enkhbold470/iron-node/media/bottom.png

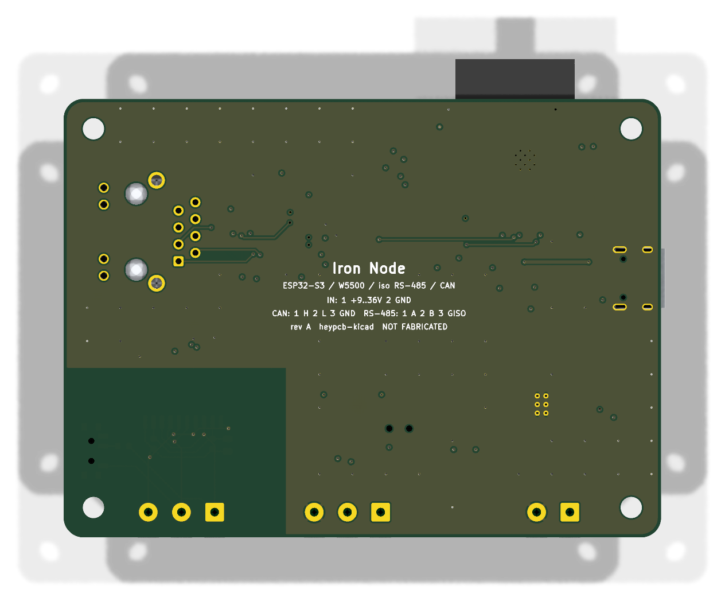
media/bottom.png
