enkhbold470/iron-node/media/top.png

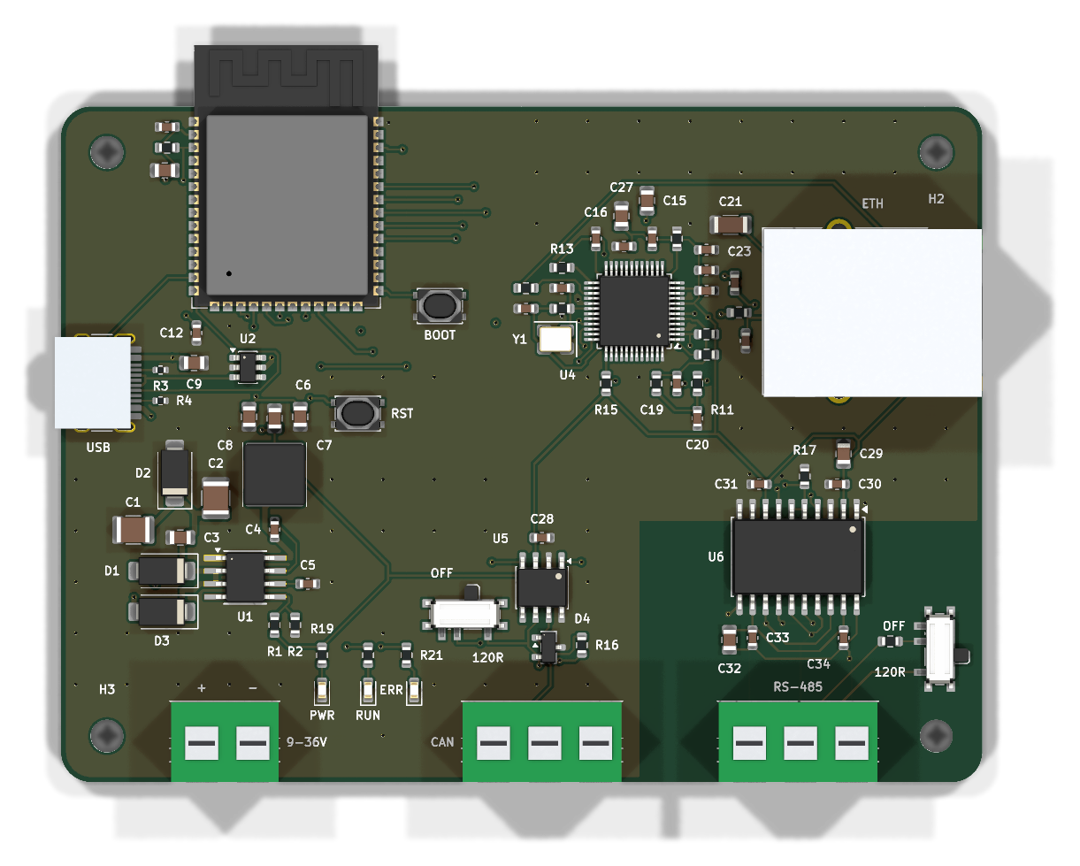
media/top.png
