enkhbold470/iron-node/fab/iron_node_bom.csv

Reference | Value | Footprint | MPN | LCSC | Qty
C1,C2 | 2.2uF | Capacitor_SMD:C_1210_3225Metric | FS32X225K101EGG | C153036 | 2
C3 | 100nF | Capacitor_SMD:C_0805_2012Metric | CL21B104KCFNNNE | C28233 | 1
C4,C10,C22,C23,C24,C25,C26,C28,C30,C31,C33,C34 | 100nF | Capacitor_SMD:C_0603_1608Metric | CC0603KRX7R9BB104 | C14663 | 12
C5,C12 | 1uF | Capacitor_SMD:C_0603_1608Metric | CL10A105KB8NNNC | C15849 | 2
C6,C7,C8,C11 | 22uF | Capacitor_SMD:C_0805_2012Metric | CL21A226MAQNNNE | C45783 | 4
C9,C27,C29,C32 | 10uF | Capacitor_SMD:C_0805_2012Metric | CL21A106KAYNNNE | C15850 | 4
C13,C14 | 18pF | Capacitor_SMD:C_0603_1608Metric | CL10C180JB8NNNC | C1647 | 2
C15 | 4.7uF | Capacitor_SMD:C_0805_2012Metric | CL21A475KAQNNNE | C1779 | 1
C16,C20 | 10nF | Capacitor_SMD:C_0603_1608Metric | 0603B103K500NT | C57112 | 2
C17 | 22nF | Capacitor_SMD:C_0603_1608Metric | CL10B223KB8NNNC | C21122 | 1
C18,C19 | 6.8nF | Capacitor_SMD:C_0603_1608Metric | 0603B682K500NT | C1631 | 2
C21 | 1nF | Capacitor_SMD:C_1206_3216Metric | 1206B102K202NT | C9196 | 1
D1,D3 | SS36 | Diode_SMD:D_SMA | SS36 | C16015 | 2
D2 | SMAJ36A | Diode_SMD:D_SMA | SMAJ36A | C113967 | 1
D4 | NUP2105L | Package_TO_SOT_SMD:SOT-23 | NUP2105LT1G | C14486 | 1
D5 | Red (PWR) | LED_SMD:LED_0603_1608Metric | KT-0603R | C2286 | 1
D6 | Orange (RUN) | LED_SMD:LED_0603_1608Metric | XL-1608UOC-06 | C965800 | 1
D7 | Red (ERR) | LED_SMD:LED_0603_1608Metric | KT-0603R | C2286 | 1
J1 | 9-36V IN | TerminalBlock:TerminalBlock_MaiXu_MX126-5.0-02P_1x02_P5.00mm | MX126-5.0-02P-GN01-Cu-S-A | C5188434 | 1
J2 | USB-C | Connector_USB:USB_C_Receptacle_HRO_TYPE-C-31-M-12 | TYPE-C-31-M-12 | C165948 | 1
J3 | HR911105A | Connector_RJ:RJ45_Hanrun_HR911105A_Horizontal | HR911105A | C12074 | 1
J4 | CAN | TerminalBlock:TerminalBlock_MaiXu_MX126-5.0-03P_1x03_P5.00mm | MX126-5.0-03P-GN01-Cu-S-A | C5188435 | 1
J5 | RS-485 | TerminalBlock:TerminalBlock_MaiXu_MX126-5.0-03P_1x03_P5.00mm | MX126-5.0-03P-GN01-Cu-S-A | C5188435 | 1
L1 | 22uH | Inductor_SMD:L_Sunlord_SWPA6045S | SWPA6045S220MT | C83454 | 1
R1 | 47k | Resistor_SMD:R_0603_1608Metric | 0603WAF4702T5E | C25819 | 1
R2 | 20k | Resistor_SMD:R_0603_1608Metric | 0603WAF2002T5E | C4184 | 1
R3,R4 | 5.1k | Resistor_SMD:R_0402_1005Metric | 0402WGF5101TCE | C25905 | 2
R5,R15,R17 | 10k | Resistor_SMD:R_0603_1608Metric | 0603WAF1002T5E | C25804 | 3
R6 | 1M | Resistor_SMD:R_0603_1608Metric | 0603WAF1004T5E | C22935 | 1
R7 | 12.4k | Resistor_SMD:R_0603_1608Metric | FRC0603F1242TS | C2930060 | 1
R8,R9,R11,R12 | 49.9 | Resistor_SMD:R_0603_1608Metric | 0603WAF499JT5E | C23185 | 4
R10 | 10 | Resistor_SMD:R_0603_1608Metric | 0603WAF100JT5E | C22859 | 1
R13,R14 | 330 | Resistor_SMD:R_0603_1608Metric | 0603WAF3300T5E | C23138 | 2
R16,R18 | 120 | Resistor_SMD:R_0603_1608Metric | 0603WAF1200T5E | C22787 | 2
R19,R20,R21 | 1k | Resistor_SMD:R_0603_1608Metric | 0603WAF1001T5E | C21190 | 3
SW1,SW2 | PCM12 | Button_Switch_SMD:SW_SPDT_PCM12 | PCM12SMTR | C221841 | 2
SW3 | BOOT | Button_Switch_SMD:SW_SPST_PTS810 | PTS810SJM250SMTRLFS | C116501 | 1
SW4 | RESET | Button_Switch_SMD:SW_SPST_PTS810 | PTS810SJM250SMTRLFS | C116501 | 1
U1 | LMR36510ADDAR | Package_SO:Texas_HTSOP-8-1EP_3.9x4.9mm_P1.27mm_EP2.95x4.9mm_Mask2.4x3.1mm_ThermalVias | LMR36510ADDAR | C1858393 | 1
U2 | USBLC6-2SC6 | Package_TO_SOT_SMD:SOT-23-6 | USBLC6-2SC6 | C7519 | 1
U3 | ESP32-S3-WROOM-1-N8R8 | RF_Module:ESP32-S3-WROOM-1 | ESP32-S3-WROOM-1-N8R8 | C2913201 | 1
U4 | W5500 | Package_QFP:LQFP-48_7x7mm_P0.5mm | W5500 | C32843 | 1
U5 | SN65HVD230DR | Package_SO:SOIC-8_3.9x4.9mm_P1.27mm | SN65HVD230DR | C12084 | 1
U6 | ADM2587EBRWZ | Package_SO:SOIC-20W_7.5x12.8mm_P1.27mm | ADM2587EBRWZ-REEL7 | C12081 | 1
Y1 | 25MHz | Crystal:Crystal_SMD_3225-4Pin_3.2x2.5mm | X322525MOB4SI | C9006 | 1
