enkhbold470/iron-node/fab/iron_node.step

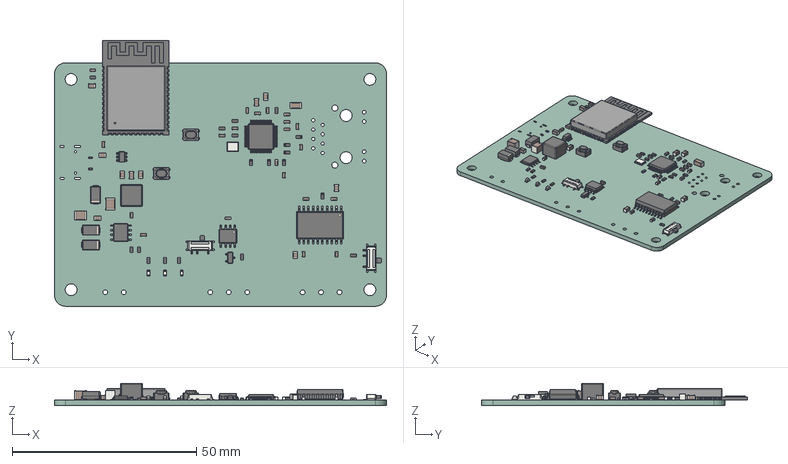
[picture p5: CAD file, 2026-10-02]
fab/iron_node.step
90.0 x 72.0 x 6.09 mm
R_0603_1608Metric x 19
C_0805_2012Metric x 10
C_0603_1608Metric x 21
R_0402_1005Metric x 2
SOIC-8_3.9x4.9mm_P1.27mm
D_SMA x 3
LED_0603_1608Metric x 3
C_1210_3225Metric x 2
a6c163e6-8551-11ed-a139-00155d22e2d7_part
a6c16512-8551-11ed-a139-00155d22e2d7_part
a6c16594-8551-11ed-a139-00155d22e2d7_part
SOIC-20W_7.5x12.8mm_P1.27mm
SW_SPST_PTS810 x 2
Texas_HTSOP_8_1EP_39x49mm_P127mm_EP285x49mm_Mask24x31mm_ThermalVias
SOT-23
Fusion_sp x 2
C_1206_3216Metric
ESP32-S3-WROOM-1
Crystal_SMD_3225-4Pin_3.2x2.5mm
LQFP-48_7x7mm_P0.5mm
SOT-23-6
iron_node_PCB
