enkhbold470/iron-node/fab/iron_node_schematic.pdf

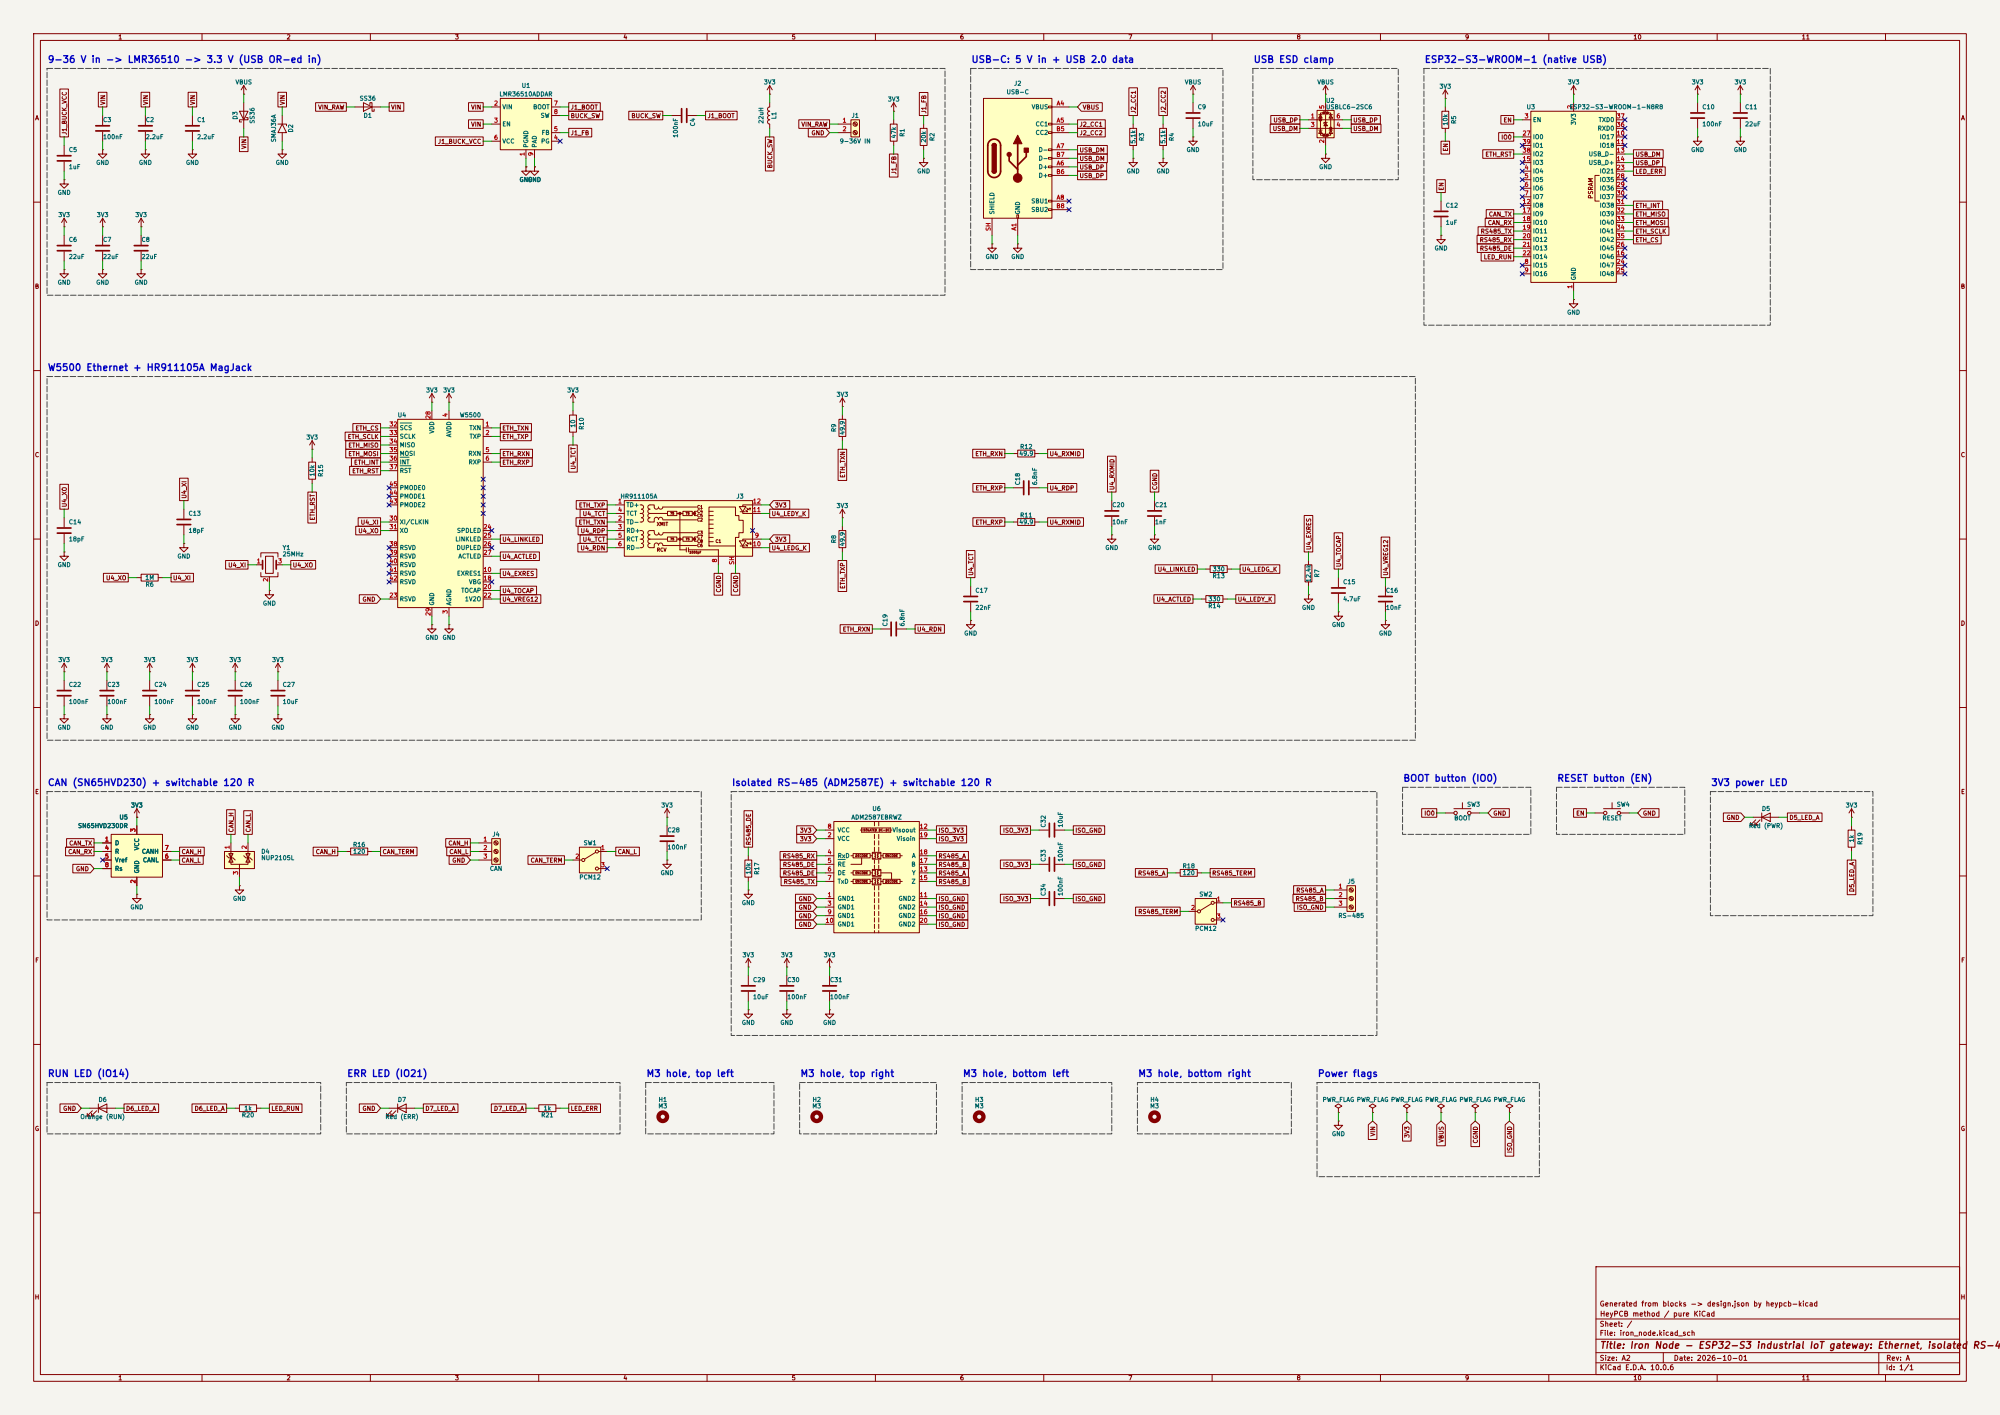
[picture p6: page 1]

HeyPCB method / pure KiCad
Sheet: /
File: iron_node.kicad_sch
Title: Iron Node - ESP32-S3 industrial IoT gateway: Ethernet, isolated RS-485, CAN, 9-36 V in

Size: A2 | Rev: A
KiCad E.D.A. 10.0.6 | Id: 1/1
