enkhbold470/iron-node/kicad/iron_node.kicad_pcb

## KiCad design kicad/iron_node.kicad_pcb (2026-10-02)

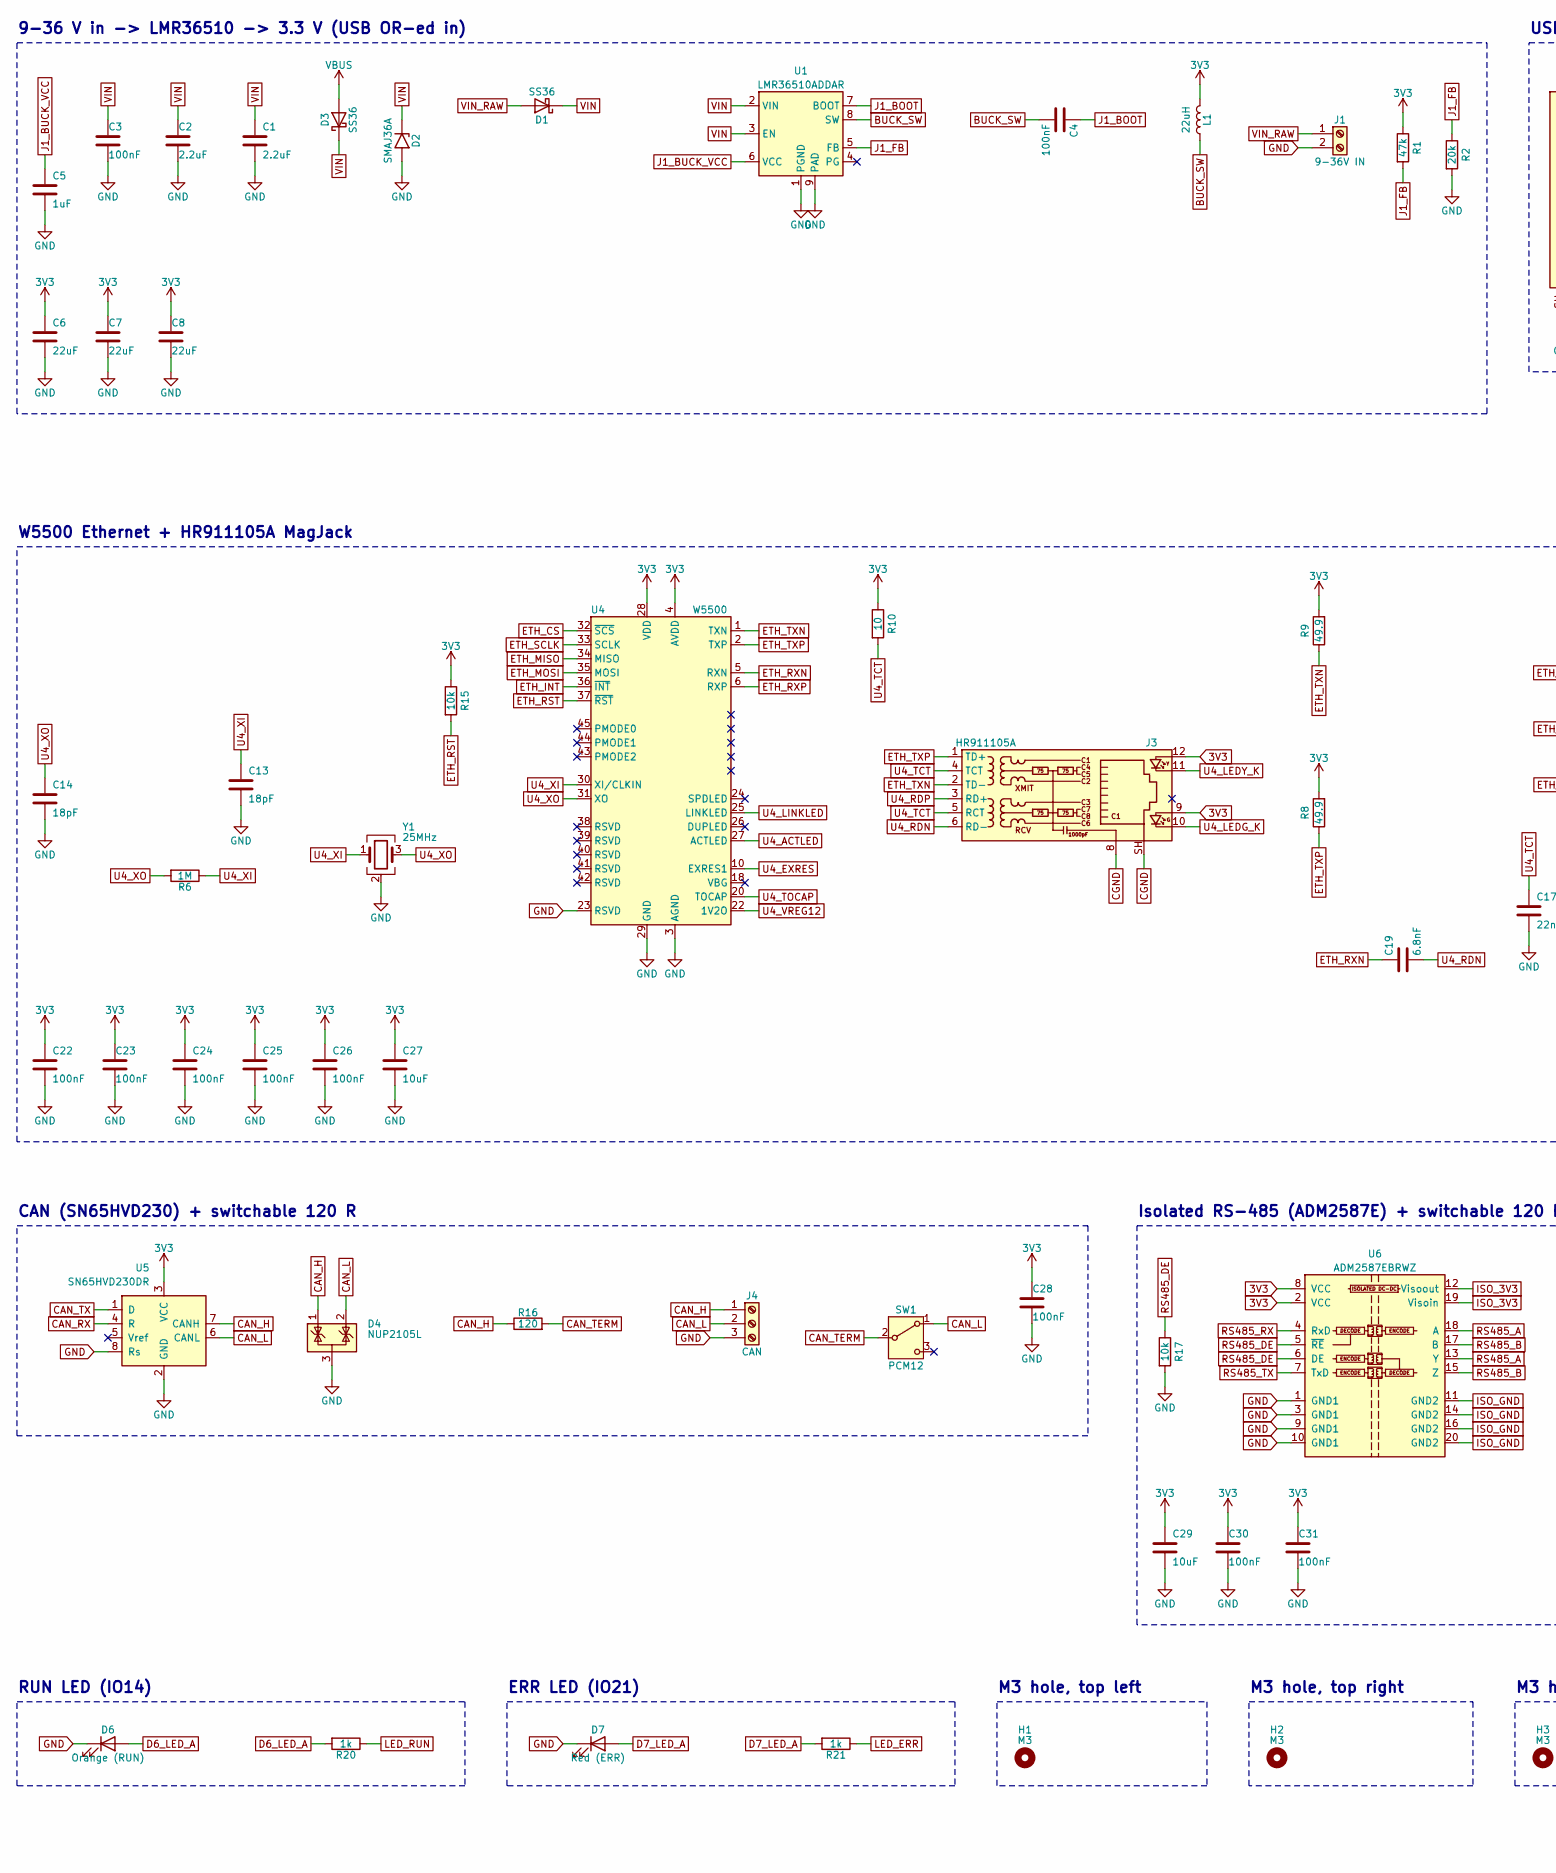
[picture p7: schematic iron_node.kicad_sch, Iron Node - ESP32-S3 industrial IoT gateway: Ethernet, isol…, part in row 1, column 1]

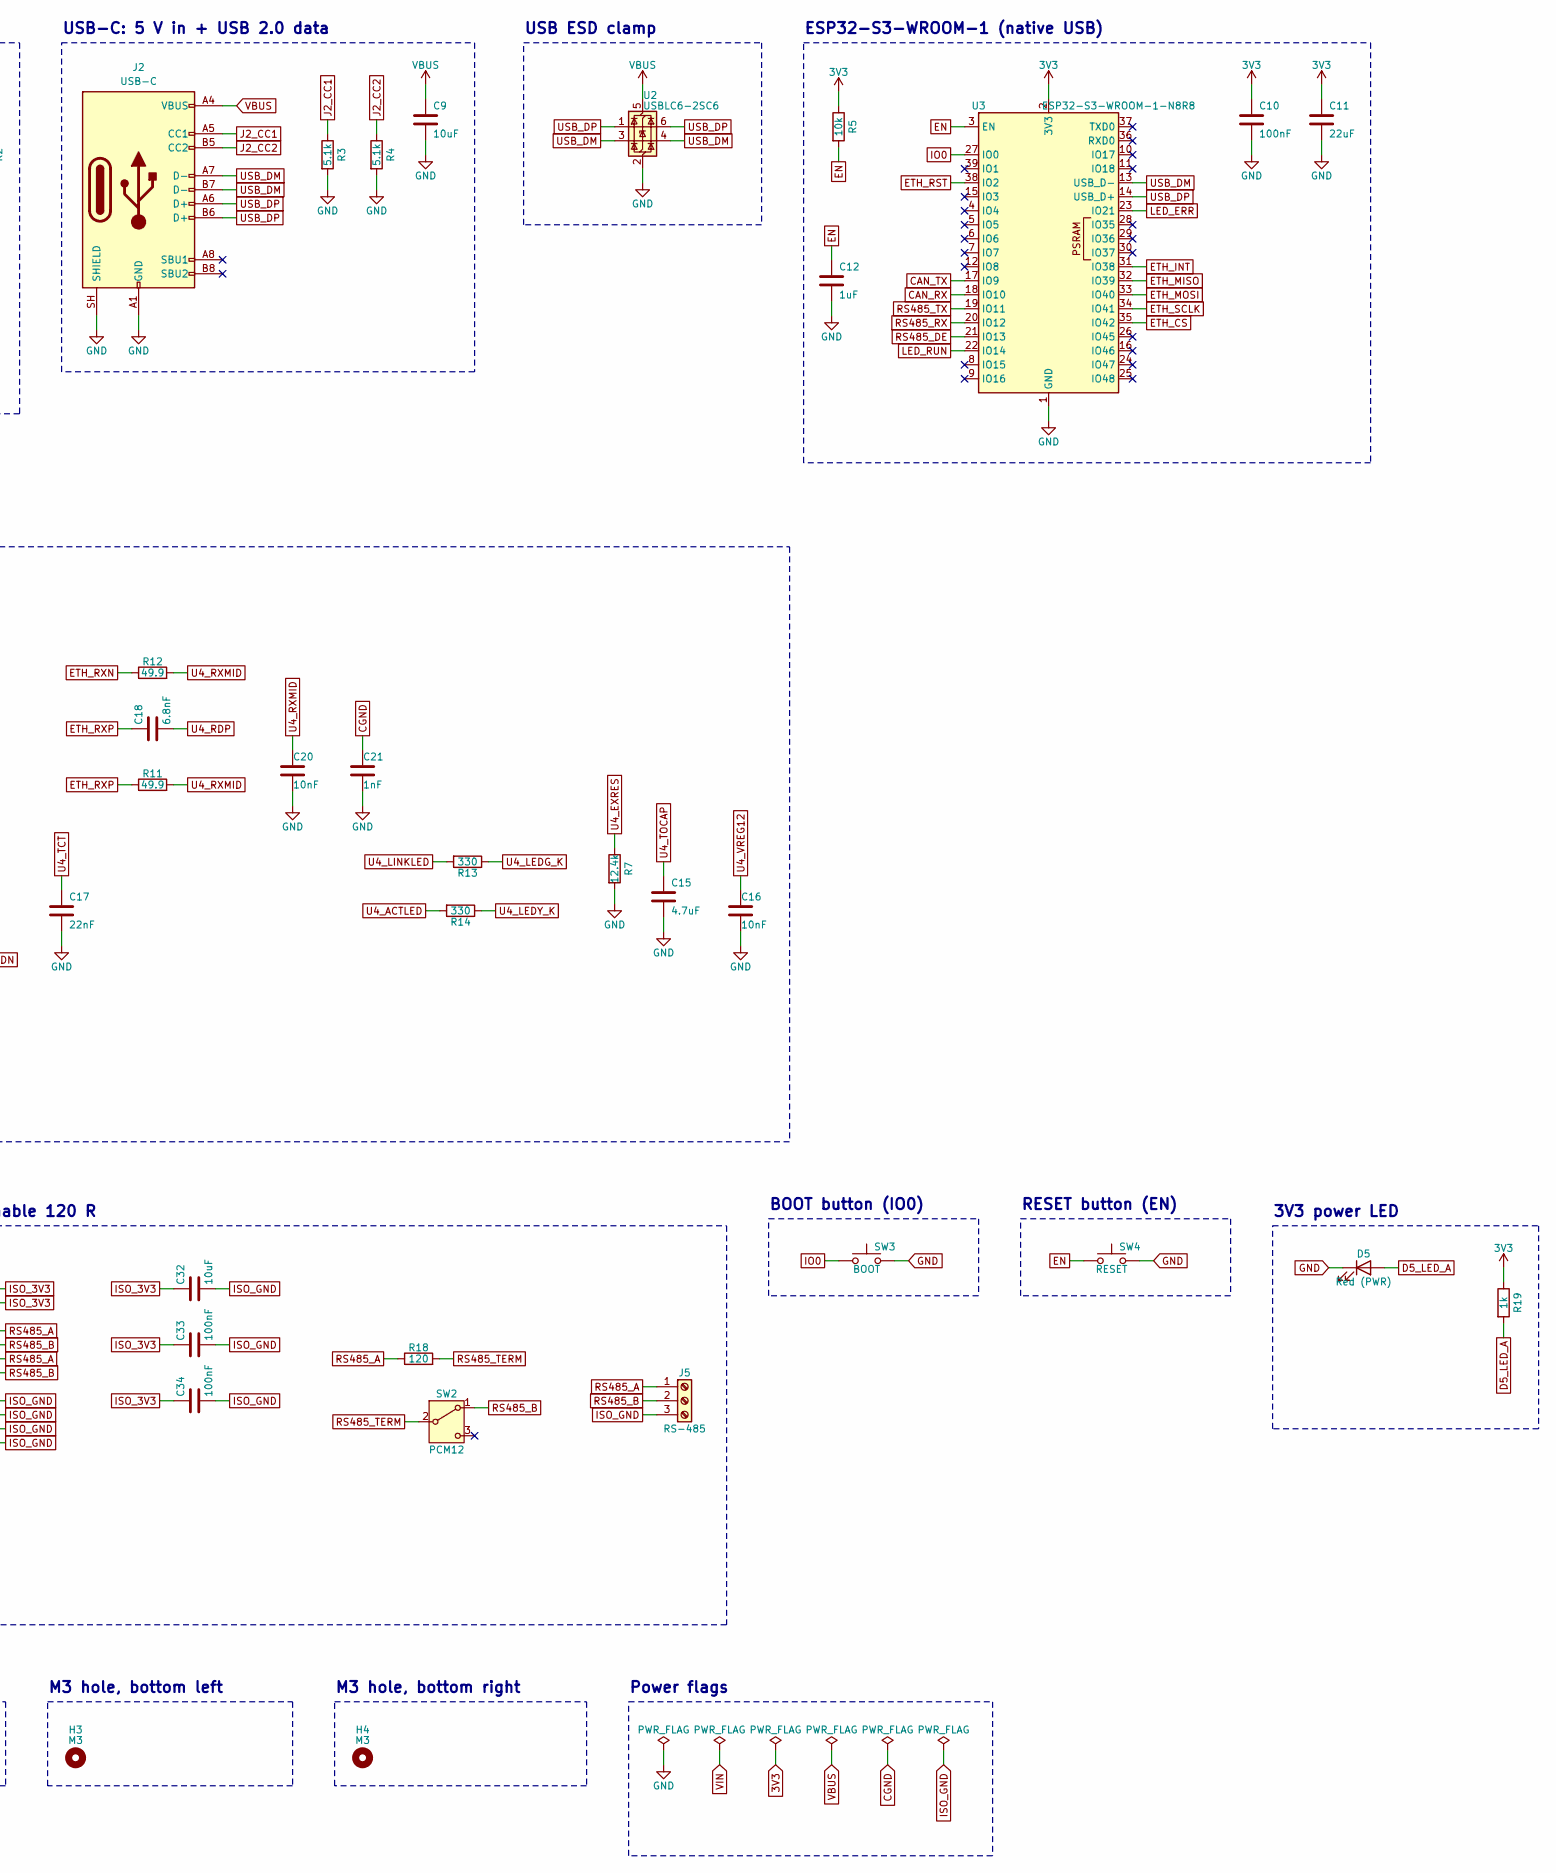
[picture p8: schematic iron_node.kicad_sch, Iron Node - ESP32-S3 industrial IoT gateway: Ethernet, isol…, part in row 1, column 2]

Parts:
C1, C2: 2.2uF; C_1210_3225Metric; MPN FS32X225K101EGG; LCSC C153036
C3: 100nF; C_0805_2012Metric; MPN CL21B104KCFNNNE; LCSC C28233
C4, C10, C22, C23, C24, C25, C26, C28, C30, C31, C33, C34: 100nF; C_0603_1608Metric; MPN CC0603KRX7R9BB104; LCSC C14663
C5, C12: 1uF; C_0603_1608Metric; MPN CL10A105KB8NNNC; LCSC C15849
C6, C7, C8, C11: 22uF; C_0805_2012Metric; MPN CL21A226MAQNNNE; LCSC C45783
C9, C27, C29, C32: 10uF; C_0805_2012Metric; MPN CL21A106KAYNNNE; LCSC C15850
C13, C14: 18pF; C_0603_1608Metric; MPN CL10C180JB8NNNC; LCSC C1647
C15: 4.7uF; C_0805_2012Metric; MPN CL21A475KAQNNNE; LCSC C1779
C16, C20: 10nF; C_0603_1608Metric; MPN 0603B103K500NT; LCSC C57112
C17: 22nF; C_0603_1608Metric; MPN CL10B223KB8NNNC; LCSC C21122
C18, C19: 6.8nF; C_0603_1608Metric; MPN 0603B682K500NT; LCSC C1631
C21: 1nF; C_1206_3216Metric; MPN 1206B102K202NT; LCSC C9196
D1, D3: SS36; D_SMA; MPN SS36; LCSC C16015
D2: SMAJ36A; D_SMA; MPN SMAJ36A; LCSC C113967
D4: NUP2105L; SOT-23; MPN NUP2105LT1G; LCSC C14486
D5: Red (PWR); LED_0603_1608Metric; MPN KT-0603R; LCSC C2286
D6: Orange (RUN); LED_0603_1608Metric; MPN XL-1608UOC-06; LCSC C965800
D7: Red (ERR); LED_0603_1608Metric; MPN KT-0603R; LCSC C2286
H1, H2, H3, H4: M3; MountingHole_3.2mm_M3
J1: 9-36V IN; TerminalBlock_MaiXu_MX126-5.0-02P_1x02_P5.00mm; MPN MX126-5.0-02P-GN01-Cu-S-A; LCSC C5188434
J2: USB-C; USB_C_Receptacle_HRO_TYPE-C-31-M-12; MPN TYPE-C-31-M-12; LCSC C165948
J3: HR911105A; RJ45_Hanrun_HR911105A_Horizontal; MPN HR911105A; LCSC C12074
J4: CAN; TerminalBlock_MaiXu_MX126-5.0-03P_1x03_P5.00mm; MPN MX126-5.0-03P-GN01-Cu-S-A; LCSC C5188435
J5: RS-485; TerminalBlock_MaiXu_MX126-5.0-03P_1x03_P5.00mm; MPN MX126-5.0-03P-GN01-Cu-S-A; LCSC C5188435
L1: 22uH; L_Sunlord_SWPA6045S; MPN SWPA6045S220MT; LCSC C83454
R1: 47k; R_0603_1608Metric; MPN 0603WAF4702T5E; LCSC C25819
R2: 20k; R_0603_1608Metric; MPN 0603WAF2002T5E; LCSC C4184
R3, R4: 5.1k; R_0402_1005Metric; MPN 0402WGF5101TCE; LCSC C25905
R5, R15, R17: 10k; R_0603_1608Metric; MPN 0603WAF1002T5E; LCSC C25804
R6: 1M; R_0603_1608Metric; MPN 0603WAF1004T5E; LCSC C22935
R7: 12.4k; R_0603_1608Metric; MPN FRC0603F1242TS; LCSC C2930060
R8, R9, R11, R12: 49.9; R_0603_1608Metric; MPN 0603WAF499JT5E; LCSC C23185
R10: 10; R_0603_1608Metric; MPN 0603WAF100JT5E; LCSC C22859
R13, R14: 330; R_0603_1608Metric; MPN 0603WAF3300T5E; LCSC C23138
R16, R18: 120; R_0603_1608Metric; MPN 0603WAF1200T5E; LCSC C22787
R19, R20, R21: 1k; R_0603_1608Metric; MPN 0603WAF1001T5E; LCSC C21190
SW1, SW2: PCM12; SW_SPDT_PCM12; MPN PCM12SMTR; LCSC C221841
SW3: BOOT; SW_SPST_PTS810; MPN PTS810SJM250SMTRLFS; LCSC C116501
SW4: RESET; SW_SPST_PTS810; MPN PTS810SJM250SMTRLFS; LCSC C116501
U1: LMR36510ADDAR; Texas_HTSOP-8-1EP_3.9x4.9mm_P1.27mm_EP2.95x4.9mm_Mask2.4x3.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; MPN LMR36510ADDAR; LCSC C1858393
U2: USBLC6-2SC6; SOT-23-6; MPN USBLC6-2SC6; LCSC C7519
U3: ESP32-S3-WROOM-1-N8R8; ESP32-S3-WROOM-1; MPN ESP32-S3-WROOM-1-N8R8; LCSC C2913201
U4: W5500; LQFP-48_7x7mm_P0.5mm; MPN W5500; LCSC C32843
U5: SN65HVD230DR; SOIC-8_3.9x4.9mm_P1.27mm; MPN SN65HVD230DR; LCSC C12084
U6: ADM2587EBRWZ; SOIC-20W_7.5x12.8mm_P1.27mm; MPN ADM2587EBRWZ-REEL7; LCSC C12081
Y1: 25MHz; Crystal_SMD_3225-4Pin_3.2x2.5mm; MPN X322525MOB4SI; LCSC C9006

Connections:
3V3: C6.1, C7.1, C8.1, C10.1, C11.1, C22.1, C23.1, C24.1, C25.1, C26.1, C27.1, C28.1, C29.1, C30.1, C31.1, J3.9, J3.12, L1.2, R1.1, R5.1, R8.2, R9.2, R10.1, R15.1, R19.1, U3.2 (3V3), U4.4 (AVDD), U4.8 (AVDD), U4.11 (AVDD), U4.15 (AVDD), U4.17 (AVDD), U4.21 (AVDD), U4.28 (VDD), U5.3 (VCC), U6.2 (VCC), U6.8 (VCC)
BUCK_SW: C4.2, L1.1, U1.8 (SW)
CAN_H: D4.1 (K), J4.1, R16.1, U5.7 (CANH)
CAN_L: D4.2 (K), J4.2, SW1.1 (A), U5.6 (CANL)
CAN_RX: U3.18 (IO10), U5.4 (R)
CAN_TERM: R16.2, SW1.2 (B)
CAN_TX: U3.17 (IO9), U5.1 (D)
CGND: C21.1, J3.8, J3.SH
D5_LED_A: D5.2 (A), R19.2
D6_LED_A: D6.2 (A), R20.2
D7_LED_A: D7.2 (A), R21.2
EN: C12.1, R5.2, SW4.1, U3.3 (EN)
ETH_CS: U3.35 (IO42), U4.32 (~SCS)
ETH_INT: U3.31 (IO38), U4.36 (~INT)
ETH_MISO: U3.32 (IO39), U4.34 (MISO)
ETH_MOSI: U3.33 (IO40), U4.35 (MOSI)
ETH_RST: R15.2, U3.38 (IO2), U4.37 (~RST)
ETH_RXN: C19.1, R12.1, U4.5 (RXN)
ETH_RXP: C18.1, R11.1, U4.6 (RXP)
ETH_SCLK: U3.34 (IO41), U4.33 (SCLK)
ETH_TXN: J3.2 (TD-), R9.1, U4.1 (TXN)
ETH_TXP: J3.1 (TD+), R8.1, U4.2 (TXP)
GND: C1.2, C2.2, C3.2, C5.2, C6.2, C7.2, C8.2, C9.2, C10.2, C11.2, C12.2, C13.2, C14.2, C15.2, C16.2, C17.2, C20.2, C21.2, C22.2, C23.2, C24.2, C25.2, C26.2, C27.2, C28.2, C29.2, C30.2, C31.2, D2.2 (A2), D4.3 (A), D5.1 (K), D6.1 (K), D7.1 (K), J1.2, J2.A1 (GND), J2.A12 (GND), J2.B1 (GND), J2.B12 (GND), J2.SH (SHIELD), J4.3, R2.2, R3.2, R4.2, R7.2, R17.2, SW3.2, SW4.2, U1.1 (PGND), U1.9 (PAD), U2.2 (GND), U3.1 (GND), U3.40 (GND), U3.41 (GND), U4.3 (AGND), U4.9 (AGND), U4.14 (AGND), U4.16 (AGND), U4.19 (AGND), U4.23 (RSVD), U4.29 (GND), U4.48 (AGND), U5.2 (GND), U5.8 (Rs), U6.1 (GND1), U6.3 (GND1), U6.9 (GND1), U6.10 (GND1), Y1.2 (G), Y1.4 (G)
IO0: SW3.1, U3.27 (IO0)
ISO_3V3: C32.1, C33.1, C34.1, U6.12 (Visoout), U6.19 (Visoin)
ISO_GND: C32.2, C33.2, C34.2, J5.3, U6.11 (GND2), U6.14 (GND2), U6.16 (GND2), U6.20 (GND2)
J1_BOOT: C4.1, U1.7 (BOOT)
J1_BUCK_VCC: C5.1, U1.6 (VCC)
J1_FB: R1.2, R2.1, U1.5 (FB)
J2_CC1: J2.A5 (CC1), R3.1
J2_CC2: J2.B5 (CC2), R4.1
LED_ERR: R21.1, U3.23 (IO21)
LED_RUN: R20.1, U3.22 (IO14)
RS485_A: J5.1, R18.1, U6.13 (Y), U6.18 (A)
RS485_B: J5.2, SW2.1 (A), U6.15 (Z), U6.17 (B)
RS485_DE: R17.1, U3.21 (IO13), U6.5 (~RE), U6.6 (DE)
RS485_RX: U3.20 (IO12), U6.4 (RxD)
RS485_TERM: R18.2, SW2.2 (B)
RS485_TX: U3.19 (IO11), U6.7 (TxD)
U4_ACTLED: R14.2, U4.27 (ACTLED)
U4_EXRES: R7.1, U4.10 (EXRES1)
U4_LEDG_K: J3.10, R13.1
U4_LEDY_K: J3.11, R14.1
U4_LINKLED: R13.2, U4.25 (LINKLED)
U4_RDN: C19.2, J3.6 (RD-)
U4_RDP: C18.2, J3.3 (RD+)
U4_RXMID: C20.1, R11.2, R12.2
U4_TCT: C17.1, J3.4 (TCT), J3.5 (RCT), R10.2
U4_TOCAP: C15.1, U4.20 (TOCAP)
U4_VREG12: C16.1, U4.22 (1V2O)
U4_XI: C13.1, R6.1, U4.30 (XI/CLKIN), Y1.1
U4_XO: C14.1, R6.2, U4.31 (XO), Y1.3
USB_DM: J2.A7 (D-), J2.B7 (D-), U2.3 (I/O2), U2.4 (I/O2), U3.13 (USB_D-)
USB_DP: J2.A6 (D+), J2.B6 (D+), U2.1 (I/O1), U2.6 (I/O1), U3.14 (USB_D+)
VBUS: C9.1, D3.2 (A), J2.A4 (VBUS), J2.A9 (VBUS), J2.B4 (VBUS), J2.B9 (VBUS), U2.5 (VBUS)
VIN: C1.1, C2.1, C3.1, D1.1 (K), D2.1 (A1), D3.1 (K), U1.2 (VIN), U1.3 (EN)
VIN_RAW: D1.2 (A), J1.1

Notes on the sheet:
9-36 V in -> LMR36510 -> 3.3 V (USB OR-ed in)
USB-C: 5 V in + USB 2.0 data
USB ESD clamp
ESP32-S3-WROOM-1 (native USB)
W5500 Ethernet + HR911105A MagJack
CAN (SN65HVD230) + switchable 120 R
Isolated RS-485 (ADM2587E) + switchable 120 R
BOOT button (IO0)
RESET button (EN)
3V3 power LED
RUN LED (IO14)
ERR LED (IO21)
M3 hole, top left
M3 hole, top right
M3 hole, bottom left
M3 hole, bottom right
Power flags

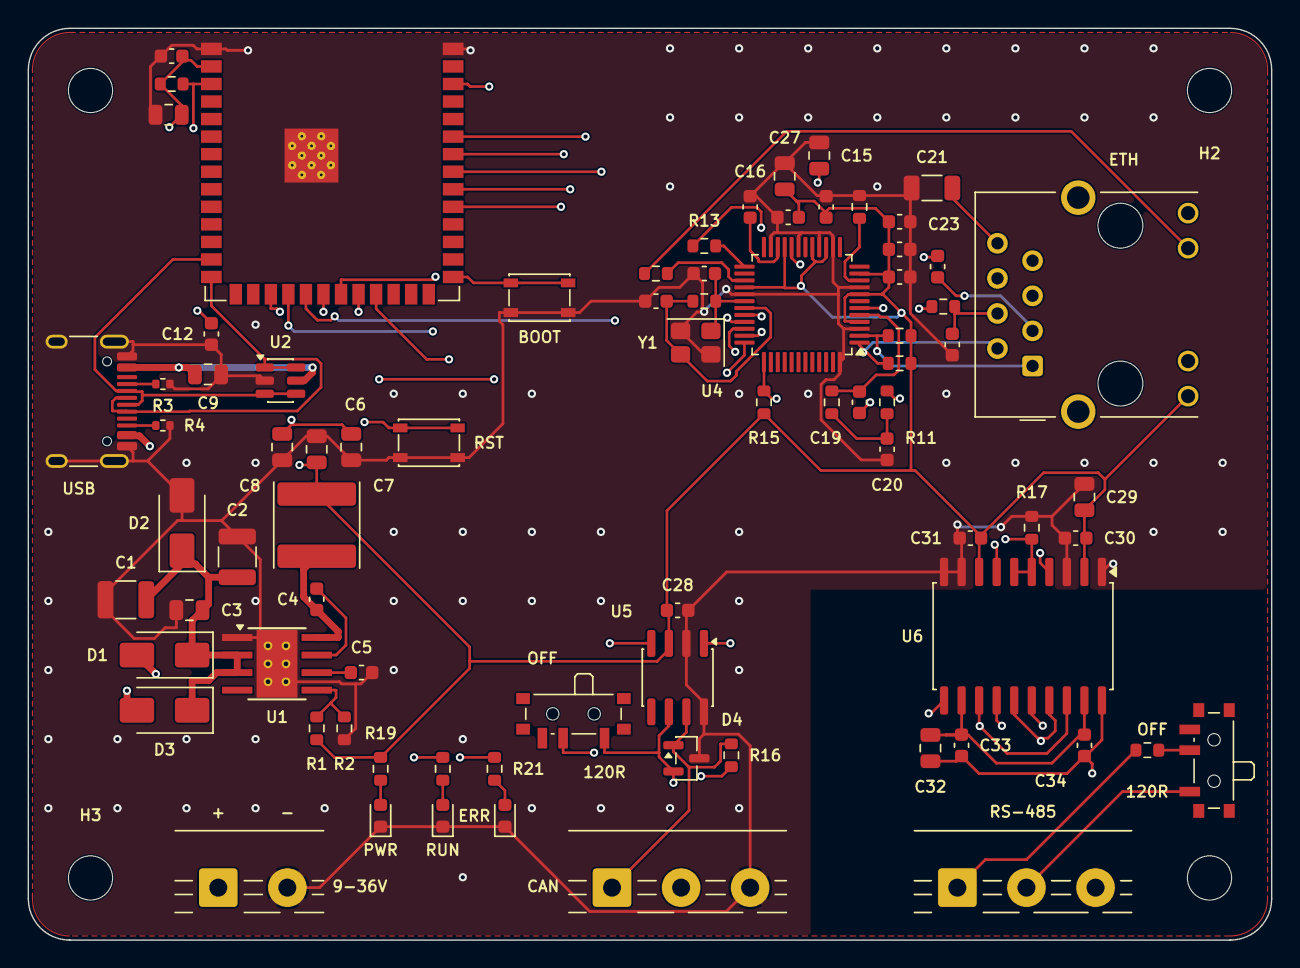
[picture p9: board iron_node.kicad_pcb from above]

Board: 4 copper layers, 90.0 x 66.0 mm, 83 parts (0 on the bottom side), 57 nets.
